RichWaWa/EternalEscape/pictures/20241227_021035.jpg

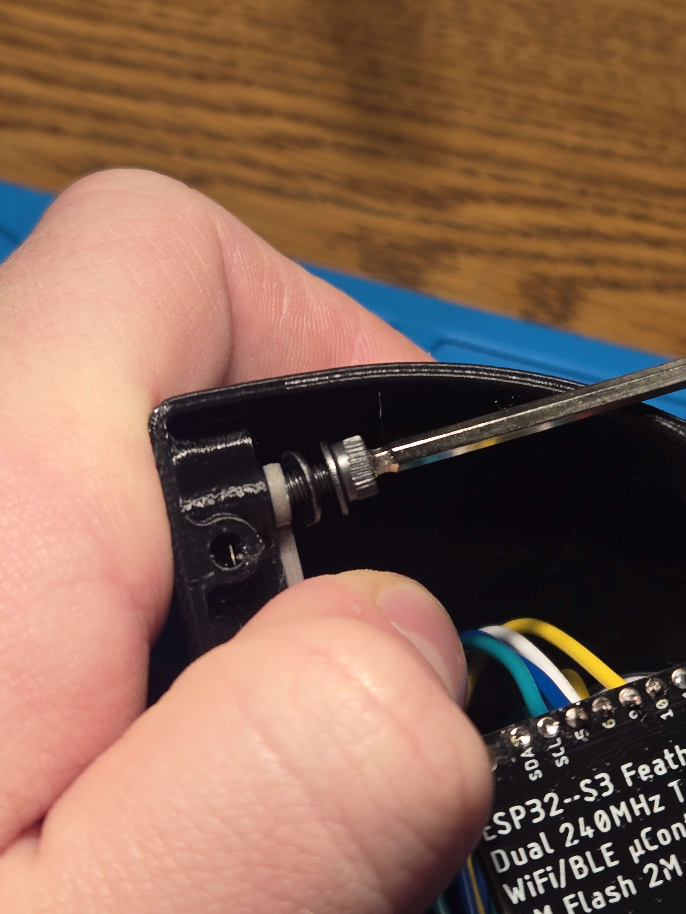
pictures/20241227_021035.jpg
