RichWaWa/EternalEscape/pictures/20241227_021052.jpg

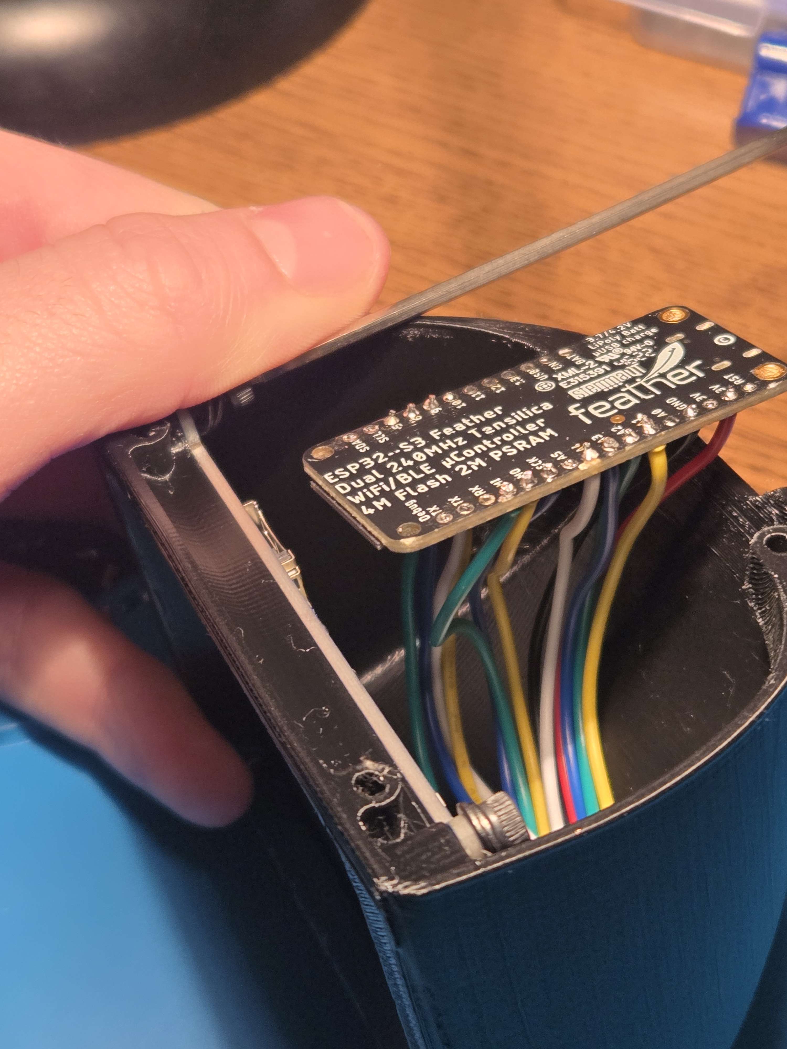
pictures/20241227_021052.jpg
