RichWaWa/EternalEscape/pictures/20241227_021418.jpg

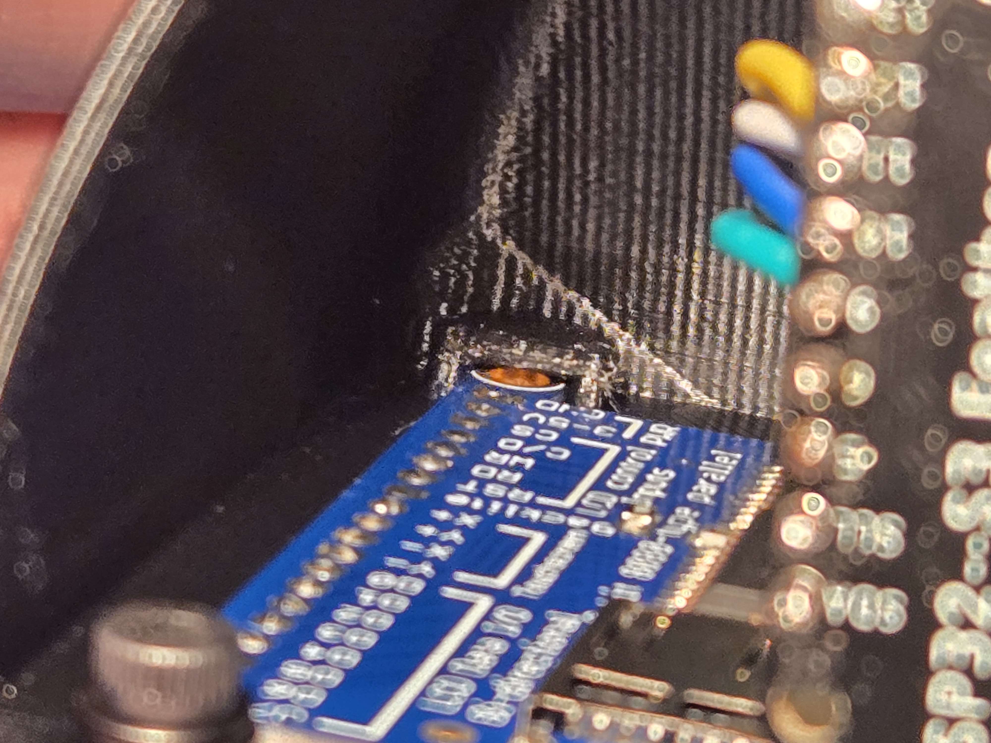
pictures/20241227_021418.jpg
