RichWaWa/EternalEscape/pictures/20250815_203037.jpg

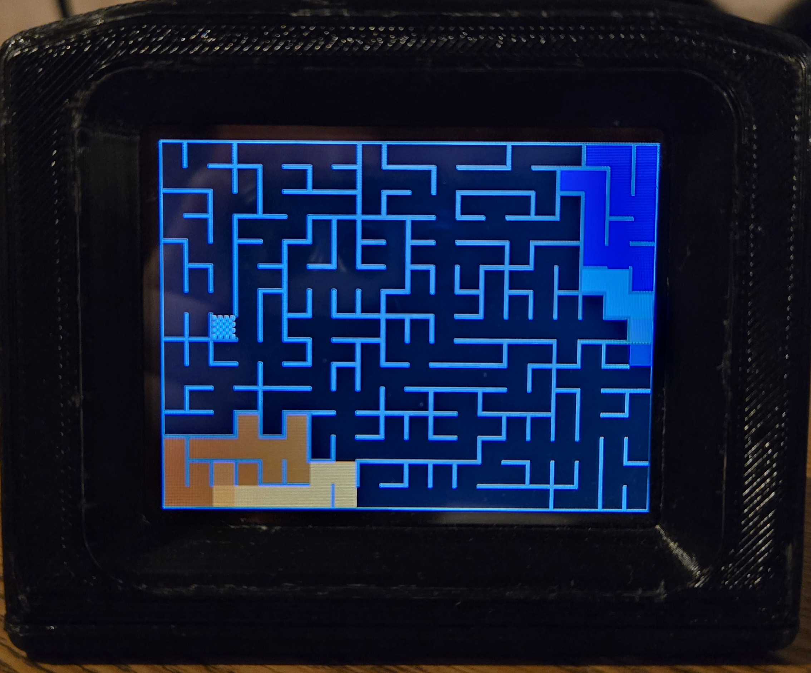
pictures/20250815_203037.jpg
