RichWaWa/EternalEscape/pictures/20250815_203052.jpg

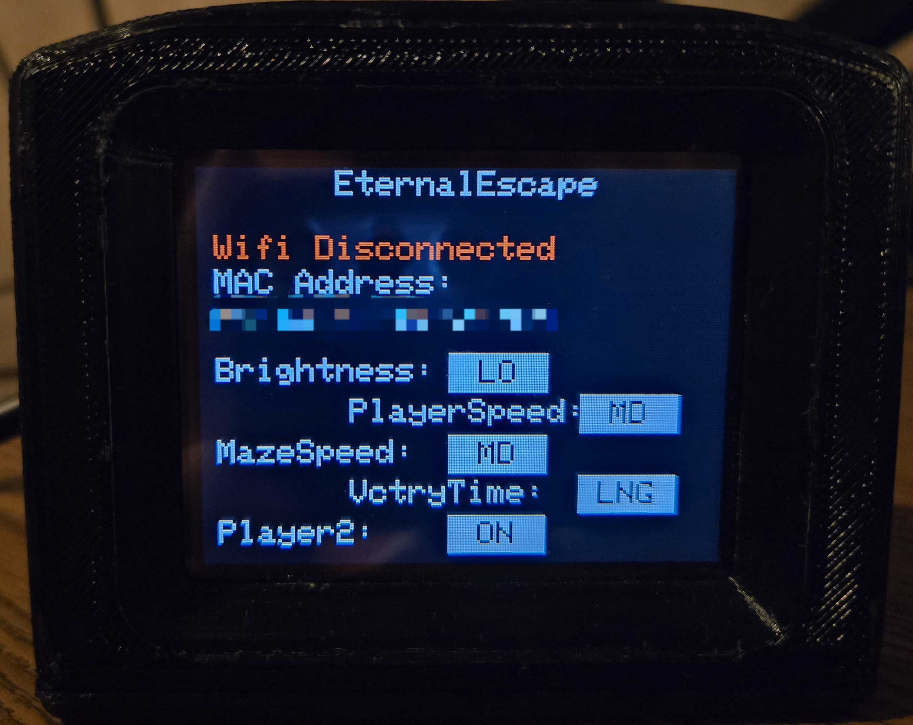
pictures/20250815_203052.jpg
