RichWaWa/EternalEscape/pictures/BOM-Photo.jpg

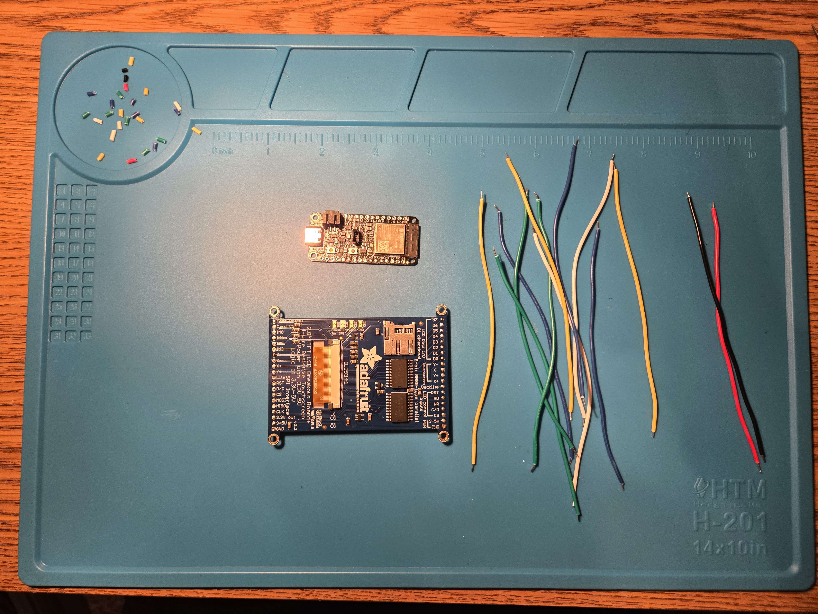
pictures/BOM-Photo.jpg
