RichWaWa/EternalEscape/Hardware/Buyouts/Type C female breakout board.step

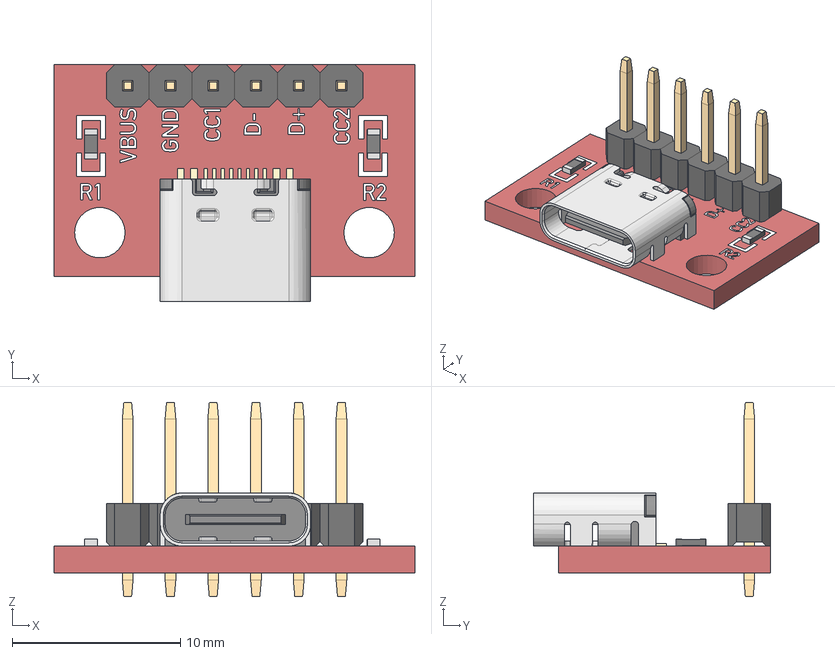
[picture p8: CAD file, 2025-08-19]
Hardware/Buyouts/Type C female breakout board.step
21.4 x 14.1 x 11.5 mm
Silk
resistor3 (13)
resistor3 (12)
Header 2.54mm 1x6
Pads
ConPins:1
PcbPins:1
Mold:1
Frame:1
PCB
