RichWaWa/EternalEscape/Hardware/Exports/OrcaProject.3mf

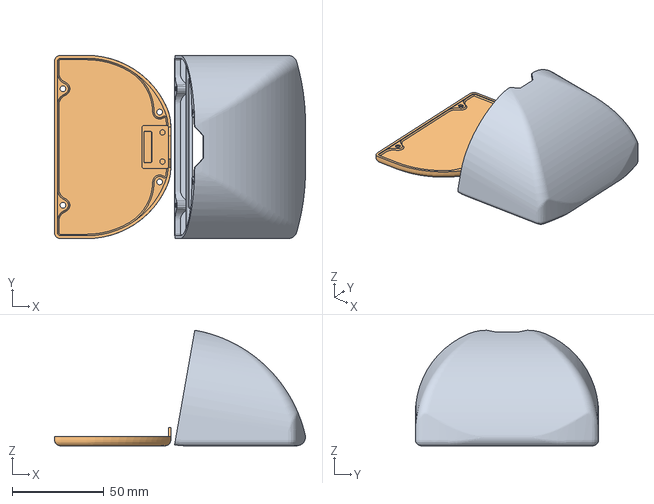
[picture p9: CAD file, 2025-08-21]
Hardware/Exports/OrcaProject.3mf
136.9 x 100.0 x 63.1 mm
Top.stl
Bottom.stl
