RichWaWa/EternalEscape/Hardware/Buyouts/5323 Feather ESP32-S3.step

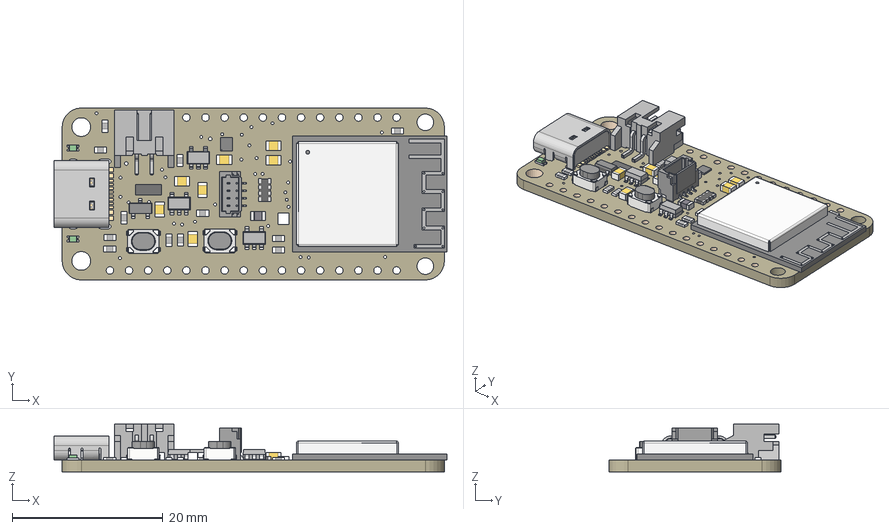
[picture p10: CAD file, 2024-12-26]
Hardware/Buyouts/5323 Feather ESP32-S3.step
52.2 x 22.9 x 6.37 mm
Board
10uF x 7
AP2112/RT9080-3.3 x 3
MBR540
JSTPH
RED x 2
1uF x 12
KMR2 x 2
DMG3415U
USB C
ESP32-S3-MINI-1
LC709203F/MH
JST SH
WS2812B_SK6805_1515
10uF_1
10K
