RichWaWa/EternalEscape/Hardware/Exports/Bottom.stl

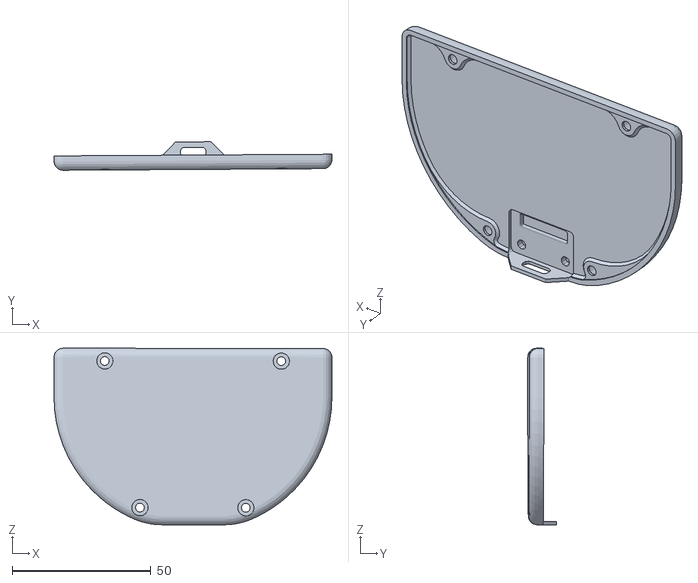
[picture p11: CAD file, 2025-08-21]
Hardware/Exports/Bottom.stl
100.0 x 10.3 x 63.6
