RichWaWa/EternalEscape/Hardware/Exports/Top.stl

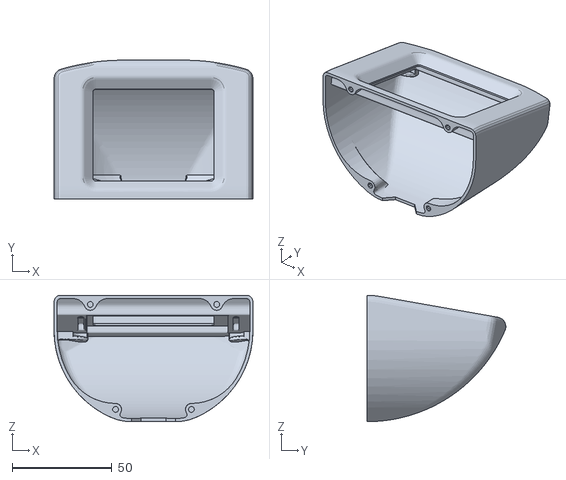
[picture p12: CAD file, 2025-08-19]
Hardware/Exports/Top.stl
100.0 x 69.7 x 63.5
