RichWaWa/EternalEscape/(list of files, cad)

Other CAD files:
Hardware/Bottom.ipt
Hardware/Buyouts/2090 2.8in TFT Cap Touch.ipt
Hardware/Buyouts/CheapYellowDisplay.ipt
Hardware/EternalEscapeMainAssy.iam
Hardware/OldVersions/Assembly1.0017.iam
Hardware/OldVersions/Bottom.0043.ipt
Hardware/OldVersions/FacePlate.0001.ipt
Hardware/OldVersions/Top.0050.ipt
Hardware/Top.ipt
