RichWaWa/EternalEscape/Hardware/EternalEscape_Wiring_Diagram.jpg

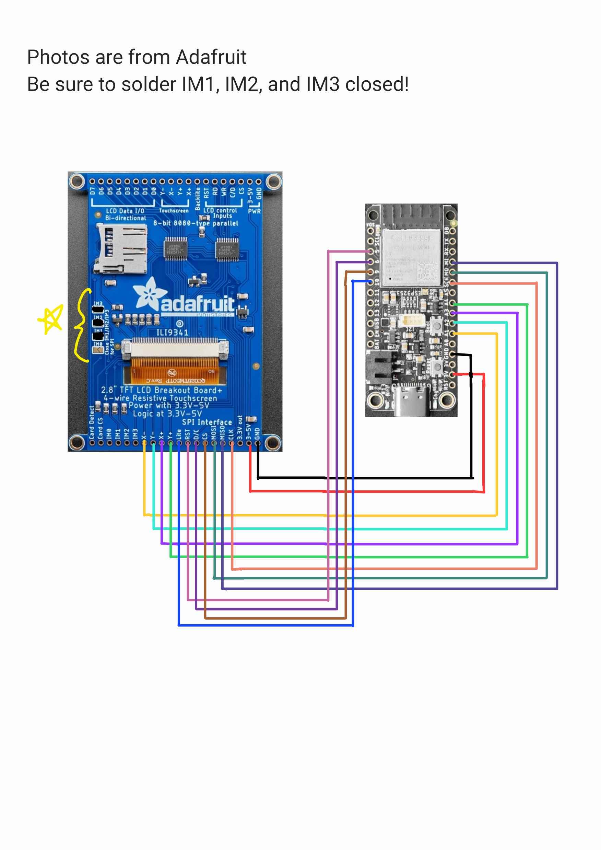
Hardware/EternalEscape_Wiring_Diagram.jpg
