RichWaWa/EternalEscape/pictures/ILI9341solder-Configs.jpg

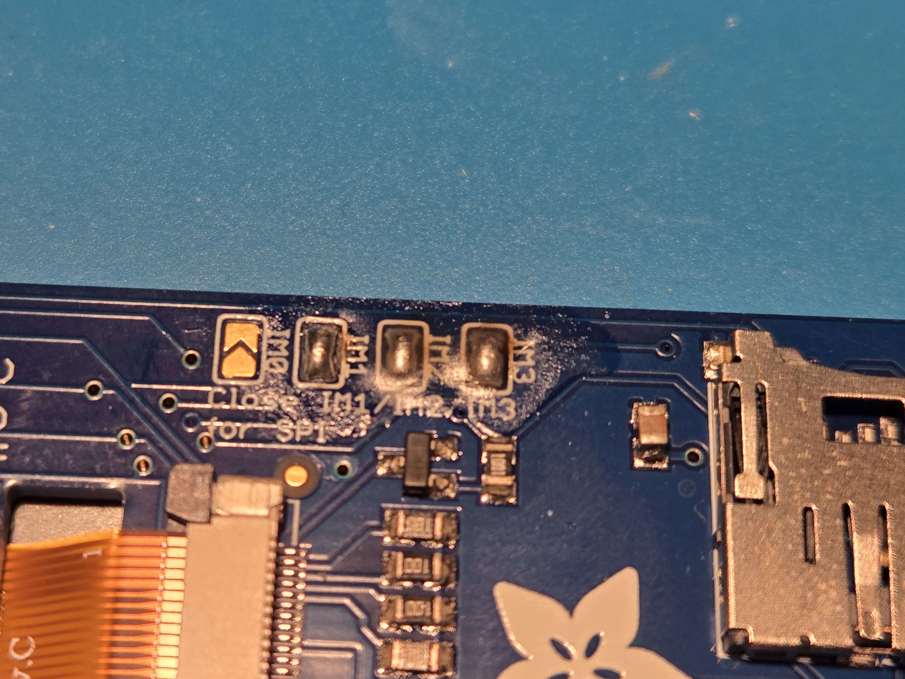
pictures/ILI9341solder-Configs.jpg
