RichWaWa/EternalEscape/pictures/Solder-Ex.jpg

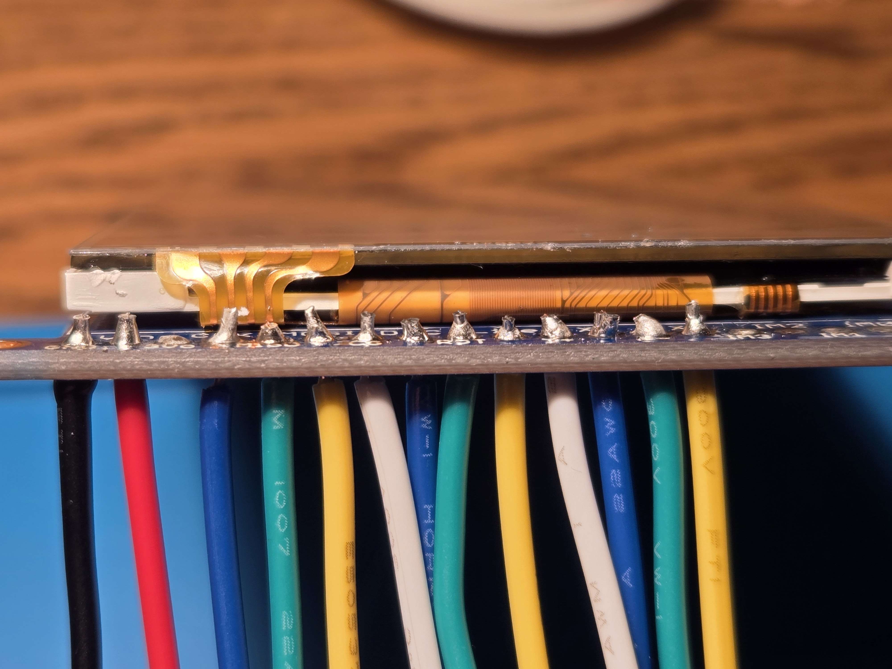
pictures/Solder-Ex.jpg
