RichWaWa/EternalEscape/(commit log)

2024-12-26 Organization
    Moved hardware and software files to the repo
    [2090 2.8in TFT Cap Touch.ipt, 5323 Feather ESP32-S3.step, Assembly1.0017.iam, Assembly1.iam, Bottom.0021.ipt, Bottom.ipt, Bottom.stl, FacePlate.0001.ipt]
2024-12-26 Update README.md
    Updated BOM
2024-12-26 Updates to Cad and Orca Models
    Fixed Orca Model due to parts not fitting. Updated some of the cad to Fix fitment issues on the display upper notches
    [Assembly1.iam, Bottom.stl, EternalEscapeMainAssy.0019.iam, EternalEscapeMainAssy.iam, OrcaProject.3mf, Top.0036.ipt, Top.0037.ipt, Top.ipt]
2024-12-27 CAD Updates
    Updates cad to fix poor tolerances.
    Added ridges to accomodate through hole wires on the uC
    [Bottom.0021.ipt, Bottom.0024.ipt, Bottom.ipt, Bottom.stl, EternalEscapeMainAssy.0019.iam, EternalEscapeMainAssy.0021.iam, EternalEscapeMainAssy.iam, OrcaProject.3mf]
2024-12-28 Committing this to make note of a bug
    BUG: The first time the device loads the settings menu after a restart, the "EternalEscape" Text is NOT centered. Going back to the maze, then back to the settings resolves this.
    [main.cpp]
2024-12-29 Fixed Settings text off centered issue. Implemented Brightness button. Brightness now toggles correctly.
    Settings still dont save.
    [main.cpp]
2024-12-29 LOTS of fixes and added features
    Settings menu loads correctly and button toggles
    NETWORKING
    Now scans for networks to connect to,
    fixed bug where its always thinks its connected.
    Added loading screen. (Looks super sexy)
    [main.cpp]
2024-12-30 Added the maze stuff I have so far.
    Fixed some settings stuff, working on implementing it
    DOES NOT COMPILE
    [main.cpp]
2024-12-30 Maze generation is still wonky. Added checkered flag to mark finish line
    Fixed settings, but the state machine is off
    [main.cpp]
2024-12-30 Got a maze printout that works kinda good. Not exactly what i want, but the algorithm works. So I gotta combine the two
2024-12-30 Ugh too tired
2025-01-28 Trying different approach to maze generation. Removed the prims algo, testing just printing the template.
    DrawElement needs to be fixed. all cells are the same size
    [main.cpp]
2025-02-06 Code now saves values to settings correctly. But doesnt load and apply them
    [main.cpp]
2025-02-06 added switch breakpoint for wall path cells
2025-02-06 Prototype maze gen code.
2025-03-03 Immediately dies when starting... Ima go sleep now. this will be fixed later
    [main.cpp]
2025-03-17 Minor changes. Player class needs some elements to keep track of positions.
    Thinking an additional vector array and then popping elements every time it moves. Or just tracking the index.
2025-03-21 Now correctly creates a new maze after finishing one
    [main.cpp]
2025-03-21 Somehow implementing the player 2 workflow crashed everything... I think its in the placeStartAndEnd
    [main.cpp]
2025-04-21 touchpoints fixed. Some buttons dont work, and the toggle player two thing is still bugged
2025-04-23 Half deconstructed code. simplifying and implementing settings fixes
    [main.cpp]
2025-04-23 everything else works, player2 is still stuck on for some reason.
    [main.cpp]
2025-08-19 CAD changed for Revision 2.0
    [Bottom.0024.ipt, Bottom.0041.ipt, Bottom.ipt, Bottom.stl, CheapYellowDisplay.ipt, EternalEscapeMainAssy.0021.iam, OrcaProject.3mf, Top.0037.ipt]
2025-08-19 CAD updates for fitment
    [Bottom.0041.ipt, Bottom.0042.ipt, Bottom.ipt, Bottom.stl, Top.0048.ipt, Top.0050.ipt, Top.ipt, Top.stl]
2025-08-21 code reformatted to incorporate new libraries. Code still uses legacy methods for buttonmaking and doesnt take advantage of the features of TFT_eSPI. However, this was supposed to be a quick and dirt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
    No known bugs, settings toggle and save. Graphics are sligned.
    TODO: Incorporate auto calibrate feature on the devices first run. Have the device check if the settings have been created and saved before, if not, then run the calibration script. After the values are saved, have it save those constants for the rest of the program to use then continue normally
    [Bottom.0042.ipt, Bottom.0043.ipt, Bottom.ipt, Bottom.stl, OrcaProject.3mf]
